watsonboyett/CanonCar/hardware/v3/Car.brd

## EAGLE design hardware/v3/Car.brd (2016-01-06)

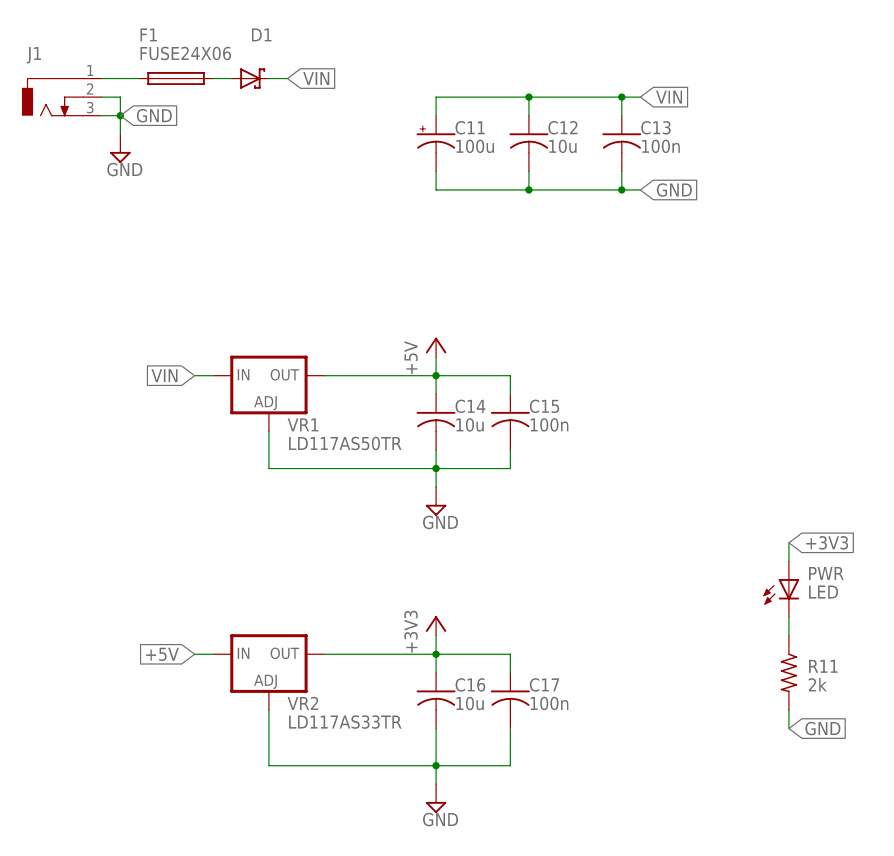
[picture p1: schematic Car.sch, sheet 1]

Parts:
C11: 100u; PANASONIC_C
C12, C14, C16: 10u; C1206
C13, C15, C17: 100n; C0805
D1: SCHOTTKY-DIODESMA; SMA
F1: FUSE24X06; 2SMD-24X06
J1: DCJ0303
PWR: LED; CHIP-LED0805
R11: 2k; R0805
VR1: LD117AS50TR; SOT223
VR2: LD117AS33TR; SOT223

Connections:
+3V3: C16.1, C17.1, PWR.A, VR2.2 (OUT), VR2.4 (OUT); also elsewhere on the board
+5V: C14.1, C15.1, VR1.2 (OUT), VR1.4 (OUT), VR2.3 (IN); also elsewhere on the board
GND: C11.-, C12.2, C13.2, C14.2, C15.2, C16.2, C17.2, J1.2, J1.3, R11.2, VR1.1 (ADJ), VR2.1 (ADJ); also elsewhere on the board
unnamed: D1.A, F1.P$2 (2)
unnamed: PWR.C, R11.1
VIN: C11.+, C12.1, C13.1, D1.C, VR1.3 (IN); also elsewhere on the board
VIN_PRF: F1.P$1 (1), J1.1

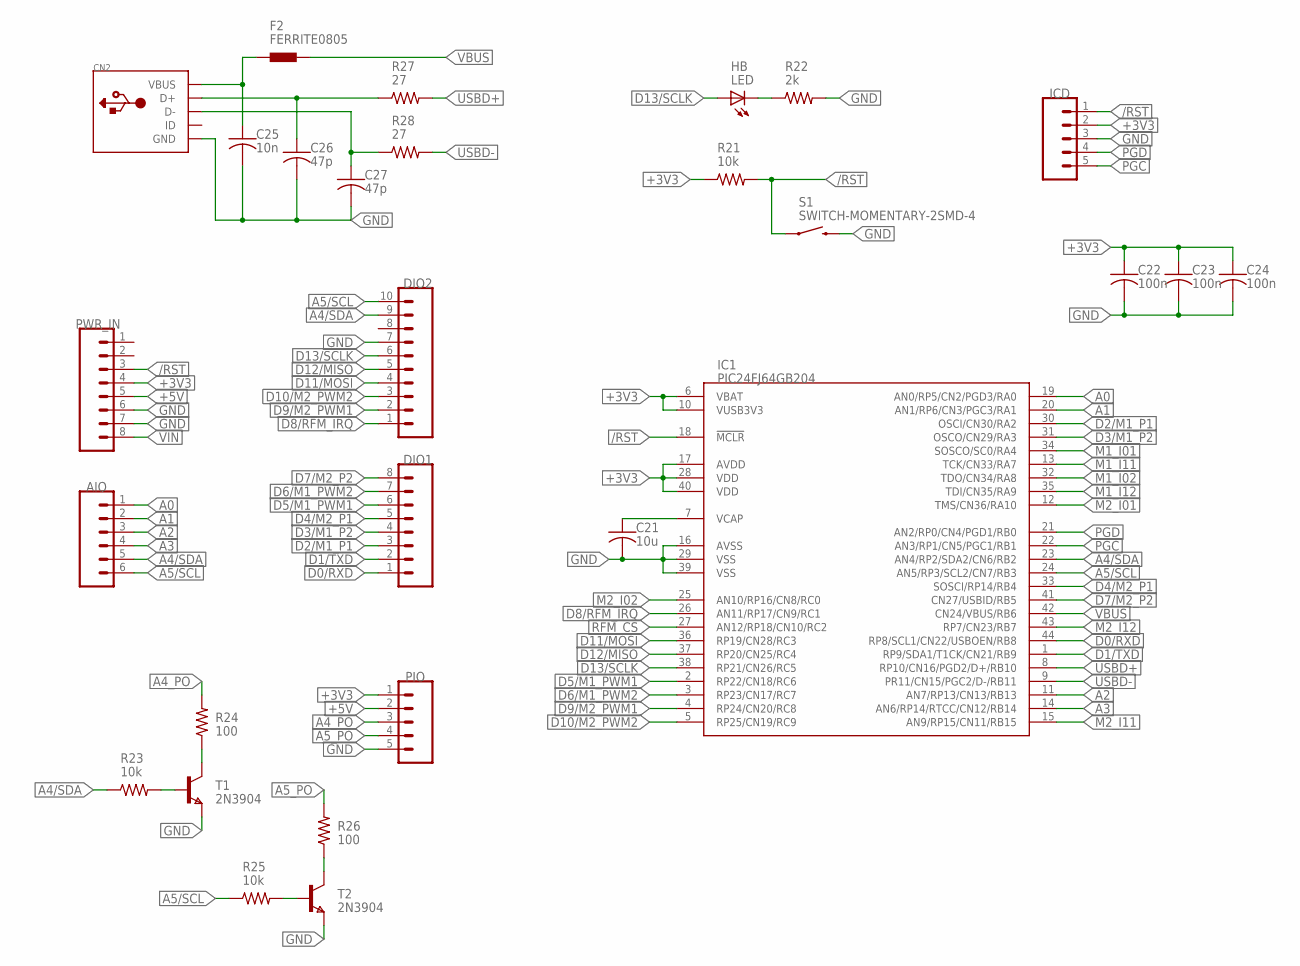
[picture p2: schematic Car.sch, sheet 2]

Parts:
AIO: M06LOCK; 1X06_LOCK
C21: 10u; C1206
C22, C23, C24: 100n; C0805
C25: 10n; C0805
C26, C27: 47p; C0805
CN2: USBMINIB; USB-MINIB
DIO1: M08LOCK; 1X08_LOCK
DIO2: M10LOCK; 1X10_LOCK
F2: FERRITE0805; 0805
HB: LED; CHIP-LED0805
IC1: PIC24FJ64GB204; TQFP44
ICD: M05LOCK; 1X05_LOCK
PIO: M05LOCK; 1X05_LOCK
PWR_IN: M08LOCK; 1X08_LOCK
R21, R23, R25: 10k; R0805
R22: 2k; R0805
R24, R26: 100; R0805
R27, R28: 27; R0805
S1: SWITCH-MOMENTARY-2SMD-4; TACTILE_SWITCH_TALL
T1, T2: 2N3904; SOT-23

Connections:
+3V3: C22.1, C23.1, C24.1, IC1.6 (VBAT), IC1.10 (VUSB3V3), IC1.17 (AVDD), IC1.28 (VDD), IC1.40 (VDD), ICD.2, PIO.1, PWR_IN.4, R21.1; also elsewhere on the board
+5V: PIO.2, PWR_IN.5; also elsewhere on the board
/RST: IC1.18 (!MCLR), ICD.1, PWR_IN.3, R21.2, S1.A2 (1); also elsewhere on the board
A0: AIO.1, IC1.19 (AN0/RP5/CN2/PGD3/RA0)
A1: AIO.2, IC1.20 (AN1/RP6/CN3/PGC3/RA1)
A2: AIO.3, IC1.11 (AN7/RP13/CN13/RB13)
A3: AIO.4, IC1.14 (AN6/RP14/RTCC/CN12/RB14)
A4/SDA: AIO.5, DIO2.9, IC1.23 (AN4/RP2/SDA2/CN6/RB2), R23.1
A4_PO: PIO.3, R24.2
A5/SCL: AIO.6, DIO2.10, IC1.24 (AN5/RP3/SCL2/CN7/RB3), R25.1
A5_PO: PIO.4, R26.2
D0/RXD: DIO1.1, IC1.44 (RP8/SCL1/CN22/USBOEN/RB8)
D1/TXD: DIO1.2, IC1.1 (RP9/SDA1/T1CK/CN21/RB9)
D2/M1_P1: DIO1.3, IC1.30 (OSCI/CN30/RA2); also elsewhere on the board
D3/M1_P2: DIO1.4, IC1.31 (OSCO/CN29/RA3); also elsewhere on the board
D4/M2_P1: DIO1.5, IC1.33 (SOSCI/RP14/RB4); also elsewhere on the board
D5/M1_PWM1: DIO1.6, IC1.2 (RP22/CN18/RC6); also elsewhere on the board
D6/M1_PWM2: DIO1.7, IC1.3 (RP23/CN17/RC7); also elsewhere on the board
D7/M2_P2: DIO1.8, IC1.41 (CN27/USBID/RB5); also elsewhere on the board
D8/RFM_IRQ: DIO2.1, IC1.26 (AN11/RP17/CN9/RC1); also elsewhere on the board
D9/M2_PWM1: DIO2.2, IC1.4 (RP24/CN20/RC8); also elsewhere on the board
D10/M2_PWM2: DIO2.3, IC1.5 (RP25/CN19/RC9); also elsewhere on the board
D11/MOSI: DIO2.4, IC1.36 (RP19/CN28/RC3); also elsewhere on the board
D12/MISO: DIO2.5, IC1.37 (RP20/CN25/RC4); also elsewhere on the board
D13/SCLK: DIO2.6, HB.A, IC1.38 (RP21/CN26/RC5); also elsewhere on the board
GND: C21.2, C22.2, C23.2, C24.2, C25.2, C26.2, C27.2, CN2.GND, DIO2.7, IC1.16 (AVSS), IC1.29 (VSS), IC1.39 (VSS), ICD.3, PIO.5, PWR_IN.6, PWR_IN.7, R22.2, S1.B2 (2), T1.2 (E), T2.2 (E); also elsewhere on the board
M1_I01: IC1.34 (SOSCO/SC0/RA4); also elsewhere on the board
M1_I02: IC1.32 (TDO/CN34/RA8); also elsewhere on the board
M1_I11: IC1.13 (TCK/CN33/RA7); also elsewhere on the board
M1_I12: IC1.35 (TDI/CN35/RA9); also elsewhere on the board
M2_I01: IC1.12 (TMS/CN36/RA10); also elsewhere on the board
M2_I02: IC1.25 (AN10/RP16/CN8/RC0); also elsewhere on the board
M2_I11: IC1.15 (AN9/RP15/CN11/RB15); also elsewhere on the board
M2_I12: IC1.43 (RP7/CN23/RB7); also elsewhere on the board
unnamed: R24.1, T1.1 (C)
unnamed: R26.1, T2.1 (C)
unnamed: R23.2, T1.3 (B)
unnamed: R25.2, T2.3 (B)
unnamed: C26.1, CN2.D+, R27.1
unnamed: C27.1, CN2.D-, R28.1
unnamed: C21.1, IC1.7 (VCAP)
unnamed: HB.C, R22.1
PGC: IC1.22 (AN3/RP1/CN5/PGC1/RB1), ICD.5
PGD: IC1.21 (AN2/RP0/CN4/PGD1/RB0), ICD.4
RFM_CS: IC1.27 (AN12/RP18/CN10/RC2); also elsewhere on the board
USBD+: IC1.8 (RP10/CN16/PGD2/D+/RB10), R27.2
USBD-: IC1.9 (PR11/CN15/PGC2/D-/RB11), R28.2
VBUS: F2.2, IC1.42 (CN24/VBUS/RB6)
VBUS-PRF: C25.1, CN2.VBUS, F2.1
VIN: PWR_IN.8; also elsewhere on the board

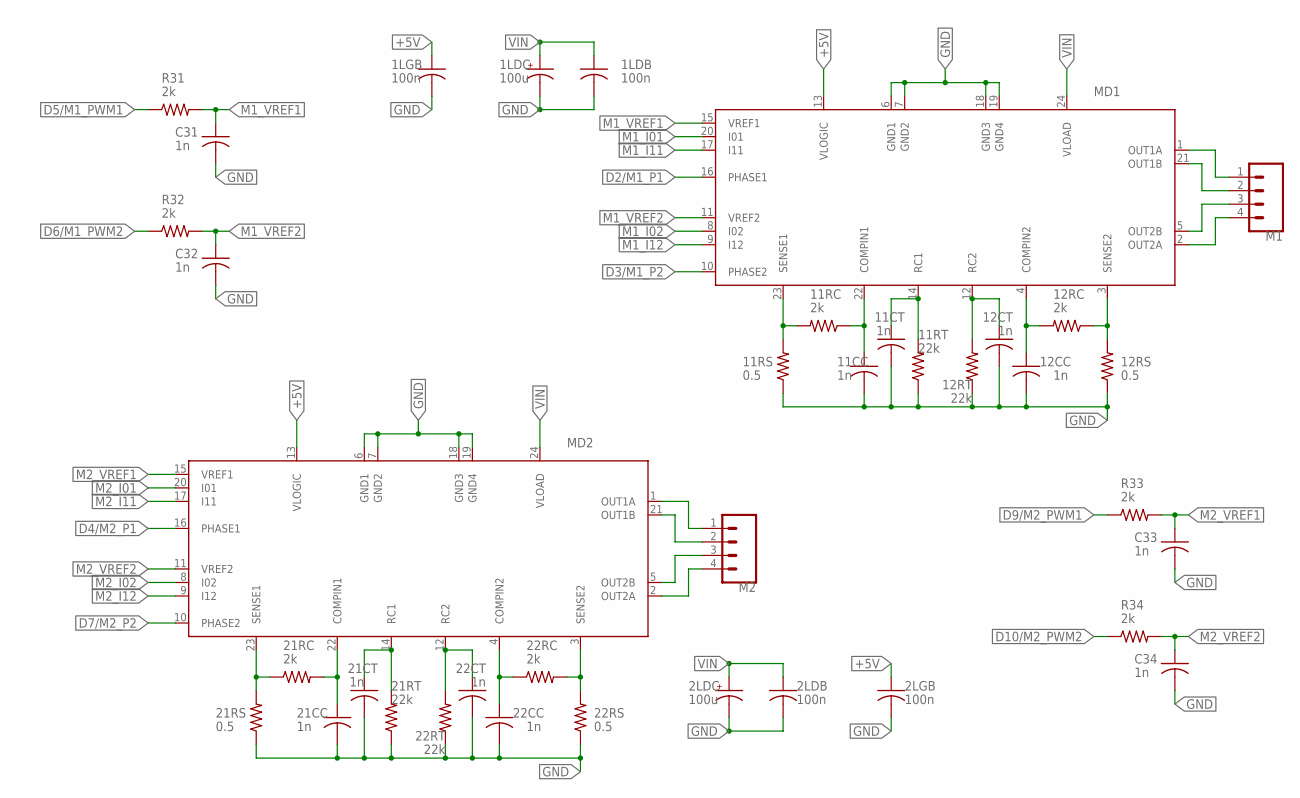
[picture p3: schematic Car.sch, sheet 3]

Parts:
1LDB, 1LGB, 2LDB, 2LGB: 100n; C0805
1LDC, 2LDC: 100u; PANASONIC_C
11CC, 11CT, 12CC, 12CT, 21CC, 21CT, 22CC, 22CT: 1n; C0805
11RC, 12RC, 21RC, 22RC: 2k; R0805
11RS, 12RS, 21RS, 22RS: 0.5; R1210
11RT, 12RT, 21RT, 22RT: 22k; R0805
C31, C32, C33, C34: 1n; C0805
M1, M2: M04LOCK; 1X04_LOCK
MD1, MD2: MTS62C19A; SOP24L
R31, R32, R33, R34: 2k; R0805

Connections:
+5V: 1LGB.1, 2LGB.1, MD1.13 (VLOGIC), MD2.13 (VLOGIC); also elsewhere on the board
D2/M1_P1: MD1.16 (PHASE1); also elsewhere on the board
D3/M1_P2: MD1.10 (PHASE2); also elsewhere on the board
D4/M2_P1: MD2.16 (PHASE1); also elsewhere on the board
D5/M1_PWM1: R31.1; also elsewhere on the board
D6/M1_PWM2: R32.1; also elsewhere on the board
D7/M2_P2: MD2.10 (PHASE2); also elsewhere on the board
D9/M2_PWM1: R33.1; also elsewhere on the board
D10/M2_PWM2: R34.1; also elsewhere on the board
GND: 1LDB.2, 1LDC.-, 1LGB.2, 2LDB.2, 2LDC.-, 2LGB.2, 11CC.2, 11CT.2, 11RS.1, 11RT.1, 12CC.2, 12CT.2, 12RS.1, 12RT.1, 21CC.2, 21CT.2, 21RS.1, 21RT.1, 22CC.2, 22CT.2, 22RS.1, 22RT.1, C31.2, C32.2, C33.2, C34.2, MD1.6 (GND1), MD1.7 (GND2), MD1.18 (GND3), MD1.19 (GND4), MD2.6 (GND1), MD2.7 (GND2), MD2.18 (GND3), MD2.19 (GND4); also elsewhere on the board
M1_I01: MD1.20 (I01); also elsewhere on the board
M1_I02: MD1.8 (I02); also elsewhere on the board
M1_I11: MD1.17 (I11); also elsewhere on the board
M1_I12: MD1.9 (I12); also elsewhere on the board
M1_VREF1: C31.1, MD1.15 (VREF1), R31.2
M1_VREF2: C32.1, MD1.11 (VREF2), R32.2
M2_I01: MD2.20 (I01); also elsewhere on the board
M2_I02: MD2.8 (I02); also elsewhere on the board
M2_I11: MD2.17 (I11); also elsewhere on the board
M2_I12: MD2.9 (I12); also elsewhere on the board
M2_VREF1: C33.1, MD2.15 (VREF1), R33.2
M2_VREF2: C34.1, MD2.11 (VREF2), R34.2
unnamed: M1.2, MD1.21 (OUT1B)
unnamed: M1.1, MD1.1 (OUT1A)
unnamed: M1.3, MD1.5 (OUT2B)
unnamed: M1.4, MD1.2 (OUT2A)
unnamed: M2.2, MD2.21 (OUT1B)
unnamed: M2.1, MD2.1 (OUT1A)
unnamed: M2.3, MD2.5 (OUT2B)
unnamed: M2.4, MD2.2 (OUT2A)
unnamed: 21RC.1, 21RS.2, MD2.23 (SENSE1)
unnamed: 21CC.1, 21RC.2, MD2.22 (COMPIN1)
unnamed: 22CT.1, 22RT.2, MD2.12 (RC2)
unnamed: 22RC.2, 22RS.2, MD2.3 (SENSE2)
unnamed: 22CC.1, 22RC.1, MD2.4 (COMPIN2)
unnamed: 21CT.1, 21RT.2, MD2.14 (RC1)
unnamed: 11RC.2, 11RS.2, MD1.23 (SENSE1)
unnamed: 11CC.1, 11RC.1, MD1.22 (COMPIN1)
unnamed: 12CC.1, 12RC.2, MD1.4 (COMPIN2)
unnamed: 12RC.1, 12RS.2, MD1.3 (SENSE2)
unnamed: 11CT.1, 11RT.2, MD1.14 (RC1)
unnamed: 12CT.1, 12RT.2, MD1.12 (RC2)
VIN: 1LDB.1, 1LDC.+, 2LDB.1, 2LDC.+, MD1.24 (VLOAD), MD2.24 (VLOAD); also elsewhere on the board

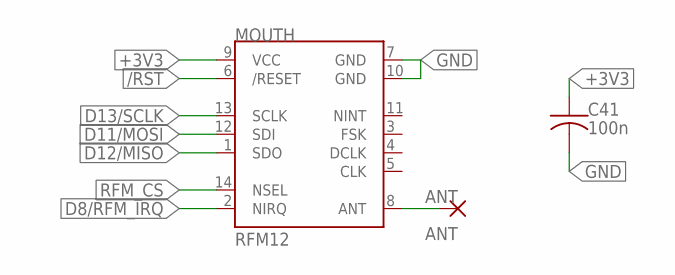
[picture p4: schematic Car.sch, sheet 4]

Parts:
ANT: ANT; 2,15/1,0
C41: 100n; C0805
MOUTH: RFM12; RFM12-XXX-S2

Connections:
+3V3: C41.1, MOUTH.9 (VCC); also elsewhere on the board
GND: C41.2, MOUTH.7 (GND), MOUTH.10 (GND); also elsewhere on the board
unnamed 48: ANT.1, MOUTH.8 (ANT); also elsewhere on the board

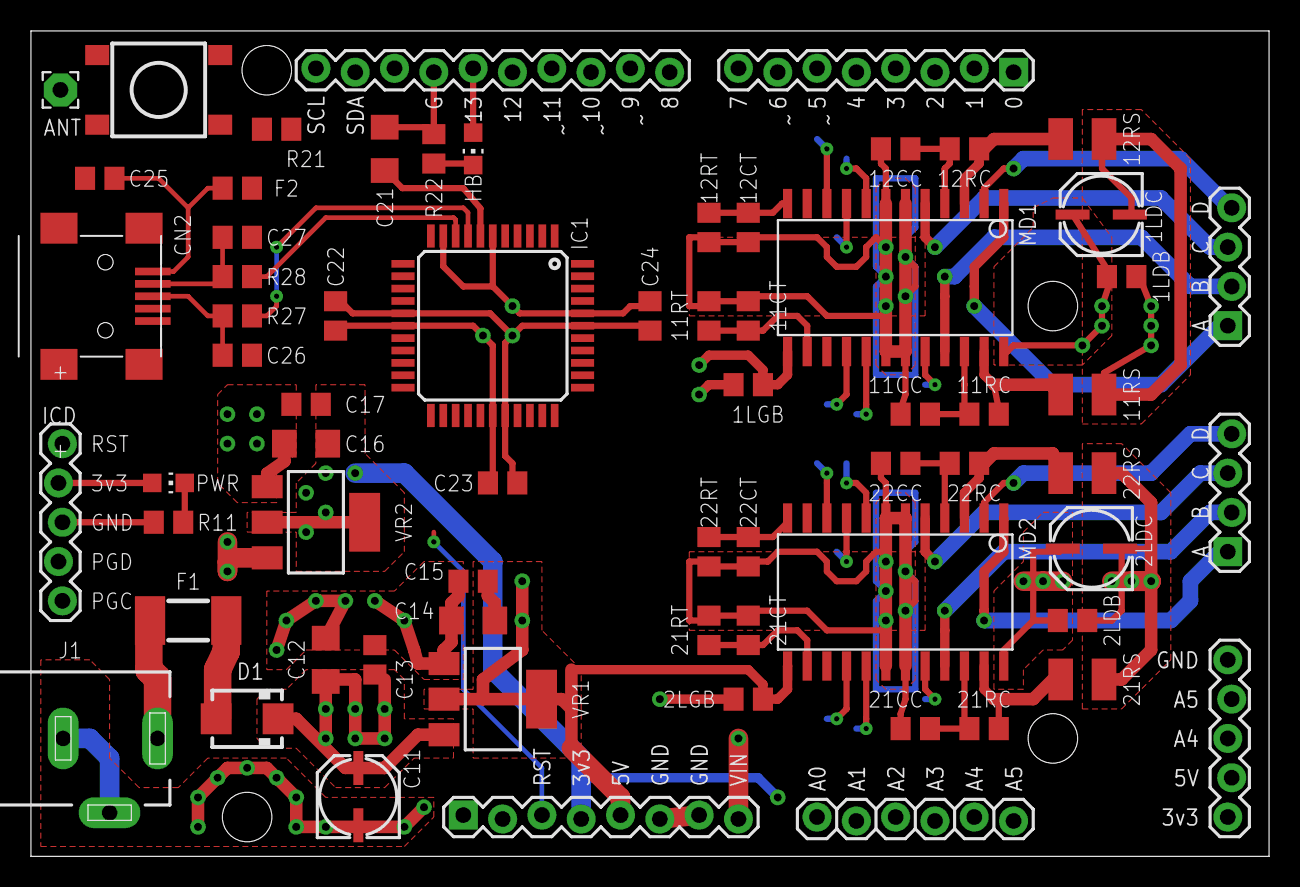
[picture p5: board hardware/v3/Car.brd from above]

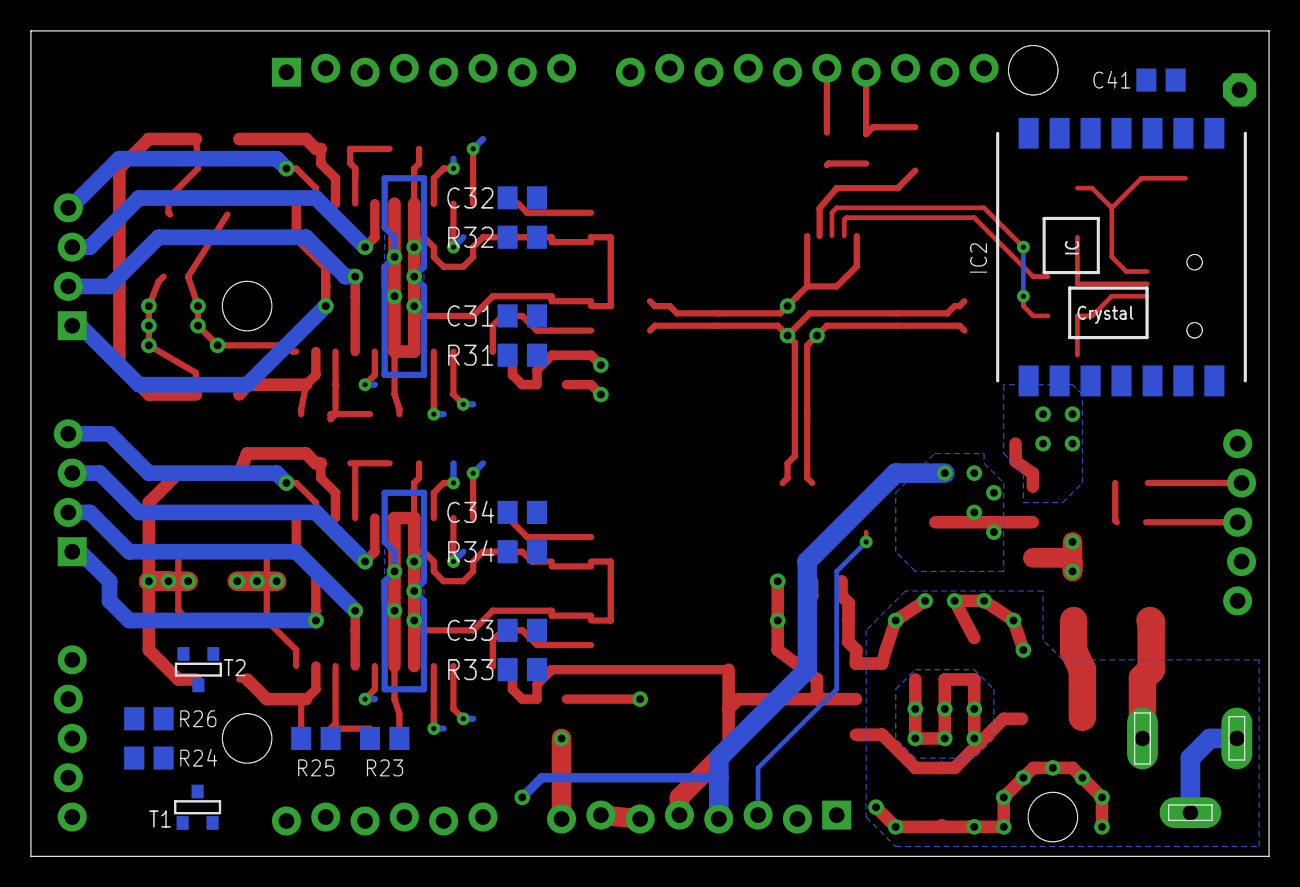
[picture p6: board hardware/v3/Car.brd from below]

Board: 4 copper layers, 80.0 x 53.3 mm, 83 parts (16 on the bottom side), 78 nets.

Other parts of the board:
IC2: RFM12; RFM12-XXX-S2

Their connections:
+3V3: IC2.9; also elsewhere on the board
/RST: IC2.6; also elsewhere on the board
D8/RFM_IRQ: IC2.2; also elsewhere on the board
D11/MOSI: IC2.12; also elsewhere on the board
D12/MISO: IC2.1; also elsewhere on the board
D13/SCLK: IC2.13; also elsewhere on the board
GND: IC2.7, IC2.10; also elsewhere on the board
unnamed 48: IC2.8; also elsewhere on the board
RFM_CS: IC2.14; also elsewhere on the board
