watsonboyett/CanonCar/hardware/v2/Car.brd

## EAGLE design hardware/v2/Car.brd (2015-11-19, an earlier design)

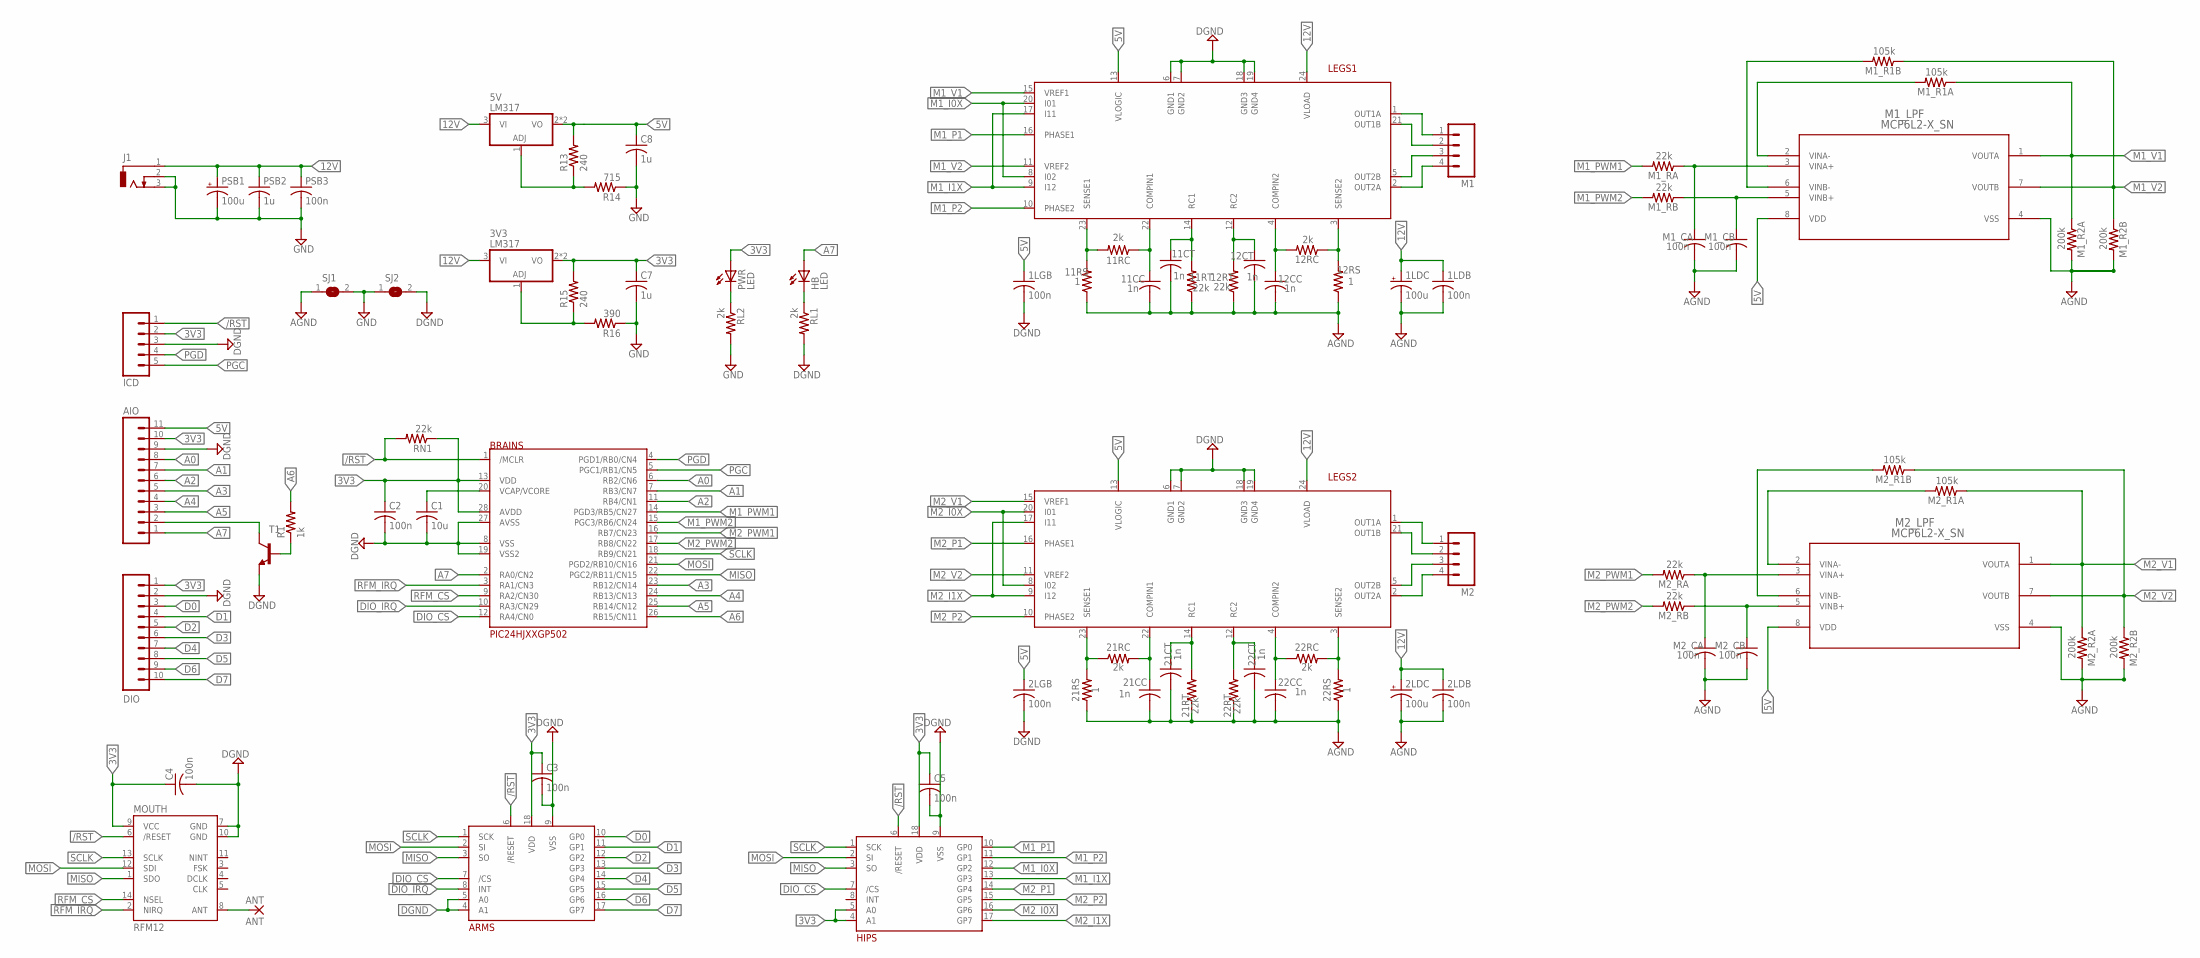
[picture p7: schematic Car.sch]

Parts:
1LDB, 1LGB, 2LDB, 2LGB: 100n; C0805
1LDC, 2LDC: 100u; PANASONIC_C
3V3, 5V: LM317; SOT23
11CC, 11CT, 12CC, 12CT, 21CC, 21CT, 22CC, 22CT: 1n; C0805
11RC, 12RC, 21RC, 22RC: 2k; R0805
11RS, 12RS, 21RS, 22RS: 1; R2512
11RT, 12RT, 21RT, 22RT: 22k; R0805
AIO: M11LOCK; 1X11_LOCK
ANT: ANT; 2,15/1,0
ARMS: MCP23S08; SO-18W
BRAINS: PIC24HJXXGP502; SO28W
C1: 10u; C1206
C2, C3, C4, C5: 100n; C0805
C7, C8: 1u; C1206
DIO: M10LOCK; 1X10_LOCK
HB: LED; CHIP-LED0805
HIPS: MCP23S08; SO-18W
ICD: M05LOCK; 1X05_LOCK
J1: DCJ0303
LEGS1, LEGS2: MTS62C19A; SOP24L
M1, M2: M04LOCK_LONGPADS; 1X04_LOCK_LONGPADS
M1_CA, M1_CB, M2_CA, M2_CB: 100n; C0805
M1_LPF, M2_LPF: MCP6L2-X_SN; SOIC8-N_MC
M1_R1A, M1_R1B, M2_R1A, M2_R1B: 105k; R0805
M1_R2A, M1_R2B, M2_R2A, M2_R2B: 200k; R0805
M1_RA, M1_RB, M2_RA, M2_RB: 22k; R0805
MOUTH: RFM12; RFM12-XXX-S2
PSB1: 100u; PANASONIC_C
PSB2: 1u; C1206
PSB3: 100n; C0805
PWR: LED; CHIP-LED0805
R1: 1k; R0805
R13, R15: 240; R0805
R14: 715; R0805
R16: 390; R0805
RL1, RL2: 2k; R0805
RN1: 22k; R0805
SJ1, SJ2: SJ
T1: BC817-16-NPN-SOT23-BEC; SOT23-BEC

Connections:
3V3: 3V3.2 (VO), 3V3.4 (VO), AIO.10, ARMS.18 (VDD), BRAINS.13 (VDD), BRAINS.28 (AVDD), C2.1, C3.1, C4.1, C5.1, C7.1, DIO.1, HIPS.4 (A1), HIPS.5 (A0), HIPS.18 (VDD), ICD.2, MOUTH.9 (VCC), PWR.A, R15.2, RN1.1
5V: 1LGB.1, 2LGB.1, 5V.2 (VO), 5V.4 (VO), AIO.11, C8.1, LEGS1.13 (VLOGIC), LEGS2.13 (VLOGIC), M1_LPF.8 (VDD), M2_LPF.8 (VDD), R13.2
12V: 1LDB.1, 1LDC.+, 2LDB.1, 2LDC.+, 3V3.3 (VI), 5V.3 (VI), J1.1, LEGS1.24 (VLOAD), LEGS2.24 (VLOAD), PSB1.+, PSB2.1, PSB3.1
/RST: ARMS.6 (/RESET), BRAINS.1 (/MCLR), HIPS.6 (/RESET), ICD.1, MOUTH.6 (/RESET), RN1.2
A0: AIO.8, BRAINS.6 (RB2/CN6)
A1: AIO.7, BRAINS.7 (RB3/CN7)
A2: AIO.6, BRAINS.11 (RB4/CN1)
A3: AIO.5, BRAINS.23 (RB12/CN14)
A4: AIO.4, BRAINS.24 (RB13/CN13)
A5: AIO.3, BRAINS.25 (RB14/CN12)
A6: BRAINS.26 (RB15/CN11), R1.2
A7: AIO.1, BRAINS.2 (RA0/CN2), HB.A
AGND: 1LDB.2, 1LDC.-, 2LDB.2, 2LDC.-, 11CC.2, 11CT.2, 11RS.1, 11RT.1, 12CC.2, 12CT.2, 12RS.1, 12RT.1, 21CC.2, 21CT.2, 21RS.1, 21RT.1, 22CC.2, 22CT.2, 22RS.1, 22RT.1, M1_CA.2, M1_CB.2, M1_LPF.4 (VSS), M1_R2A.2, M1_R2B.2, M2_CA.2, M2_CB.2, M2_LPF.4 (VSS), M2_R2A.2, M2_R2B.2, SJ1.1
D0: ARMS.10 (GP0), DIO.3
D1: ARMS.11 (GP1), DIO.4
D2: ARMS.12 (GP2), DIO.5
D3: ARMS.13 (GP3), DIO.6
D4: ARMS.14 (GP4), DIO.7
D5: ARMS.15 (GP5), DIO.8
D6: ARMS.16 (GP6), DIO.9
D7: ARMS.17 (GP7), DIO.10
DGND: 1LGB.2, 2LGB.2, AIO.9, ARMS.4 (A1), ARMS.5 (A0), ARMS.9 (VSS), BRAINS.8 (VSS), BRAINS.19 (VSS2), BRAINS.27 (AVSS), C1.2, C2.2, C3.2, C4.2, C5.2, DIO.2, HIPS.9 (VSS), ICD.3, LEGS1.6 (GND1), LEGS1.7 (GND2), LEGS1.18 (GND3), LEGS1.19 (GND4), LEGS2.6 (GND1), LEGS2.7 (GND2), LEGS2.18 (GND3), LEGS2.19 (GND4), MOUTH.7 (GND), MOUTH.10 (GND), RL1.2, SJ2.2, T1.E
DIO_CS: ARMS.7 (/CS), BRAINS.12 (RA4/CN0), HIPS.7 (/CS)
DIO_IRQ: ARMS.8 (INT), BRAINS.10 (RA3/CN29)
GND: C7.2, C8.2, J1.2, J1.3, PSB1.-, PSB2.2, PSB3.2, R14.1, R16.1, RL2.2, SJ1.2, SJ2.1
M1_I0X: HIPS.12 (GP2), LEGS1.8 (I02), LEGS1.20 (I01)
M1_I1X: HIPS.13 (GP3), LEGS1.9 (I12), LEGS1.17 (I11)
M1_P1: HIPS.10 (GP0), LEGS1.16 (PHASE1)
M1_P2: HIPS.11 (GP1), LEGS1.10 (PHASE2)
M1_PWM1: BRAINS.14 (PGD3/RB5/CN27), M1_RA.2
M1_PWM2: BRAINS.15 (PGC3/RB6/CN24), M1_RB.2
M1_V1: LEGS1.15 (VREF1), M1_LPF.1 (VOUTA), M1_R1A.1, M1_R2A.1
M1_V2: LEGS1.11 (VREF2), M1_LPF.7 (VOUTB), M1_R1B.1, M1_R2B.1
M2_I0X: HIPS.16 (GP6), LEGS2.8 (I02), LEGS2.20 (I01)
M2_I1X: HIPS.17 (GP7), LEGS2.9 (I12), LEGS2.17 (I11)
M2_P1: HIPS.14 (GP4), LEGS2.16 (PHASE1)
M2_P2: HIPS.15 (GP5), LEGS2.10 (PHASE2)
M2_PWM1: BRAINS.16 (RB7/CN23), M2_RA.2
M2_PWM2: BRAINS.17 (RB8/CN22), M2_RB.2
M2_V1: LEGS2.15 (VREF1), M2_LPF.1 (VOUTA), M2_R1A.1, M2_R2A.1
M2_V2: LEGS2.11 (VREF2), M2_LPF.7 (VOUTB), M2_R1B.1, M2_R2B.1
MISO: ARMS.3 (SO), BRAINS.22 (PGC2/RB11/CN15), HIPS.3 (SO), MOUTH.1 (SDO)
MOSI: ARMS.2 (SI), BRAINS.21 (PGD2/RB10/CN16), HIPS.2 (SI), MOUTH.12 (SDI)
unnamed: LEGS1.21 (OUT1B), M1.2
unnamed: LEGS1.1 (OUT1A), M1.1
unnamed: M1_CA.1, M1_LPF.3 (VINA+), M1_RA.1
unnamed: LEGS1.5 (OUT2B), M1.3
unnamed: LEGS1.2 (OUT2A), M1.4
unnamed: LEGS2.21 (OUT1B), M2.2
unnamed: M1_LPF.2 (VINA-), M1_R1A.2
unnamed: LEGS2.1 (OUT1A), M2.1
unnamed: LEGS2.5 (OUT2B), M2.3
unnamed: LEGS2.2 (OUT2A), M2.4
unnamed: ANT.1, MOUTH.8 (ANT)
unnamed: M2_CA.1, M2_LPF.3 (VINA+), M2_RA.1
unnamed: 21RC.1, 21RS.2, LEGS2.23 (SENSE1)
unnamed: 21CC.1, 21RC.2, LEGS2.22 (COMPIN1)
unnamed: 22CT.1, 22RT.2, LEGS2.12 (RC2)
unnamed: 22RC.2, 22RS.2, LEGS2.3 (SENSE2)
unnamed: 22CC.1, 22RC.1, LEGS2.4 (COMPIN2)
unnamed: 21CT.1, 21RT.2, LEGS2.14 (RC1)
unnamed: M2_LPF.2 (VINA-), M2_R1A.2
unnamed: 3V3.1 (ADJ), R15.1, R16.2
unnamed: M1_LPF.6 (VINB-), M1_R1B.2
unnamed: M1_CB.1, M1_LPF.5 (VINB+), M1_RB.1
unnamed: M2_LPF.6 (VINB-), M2_R1B.2
unnamed: M2_CB.1, M2_LPF.5 (VINB+), M2_RB.1
unnamed: AIO.2, T1.C
unnamed: 5V.1 (ADJ), R13.1, R14.2
unnamed: R1.1, T1.B
unnamed: 11RC.2, 11RS.2, LEGS1.23 (SENSE1)
unnamed: 11CC.1, 11RC.1, LEGS1.22 (COMPIN1)
unnamed: 12CC.1, 12RC.2, LEGS1.4 (COMPIN2)
unnamed: 12RC.1, 12RS.2, LEGS1.3 (SENSE2)
unnamed: BRAINS.20 (VCAP/VCORE), C1.1
unnamed: 11CT.1, 11RT.2, LEGS1.14 (RC1)
unnamed: 12CT.1, 12RT.2, LEGS1.12 (RC2)
unnamed: HB.C, RL1.1
unnamed: PWR.C, RL2.1
PGC: BRAINS.5 (PGC1/RB1/CN5), ICD.5
PGD: BRAINS.4 (PGD1/RB0/CN4), ICD.4
RFM_CS: BRAINS.9 (RA2/CN30), MOUTH.14 (NSEL)
RFM_IRQ: BRAINS.3 (RA1/CN3), MOUTH.2 (NIRQ)
SCLK: ARMS.1 (SCK), BRAINS.18 (RB9/CN21), HIPS.1 (SCK), MOUTH.13 (SCLK)

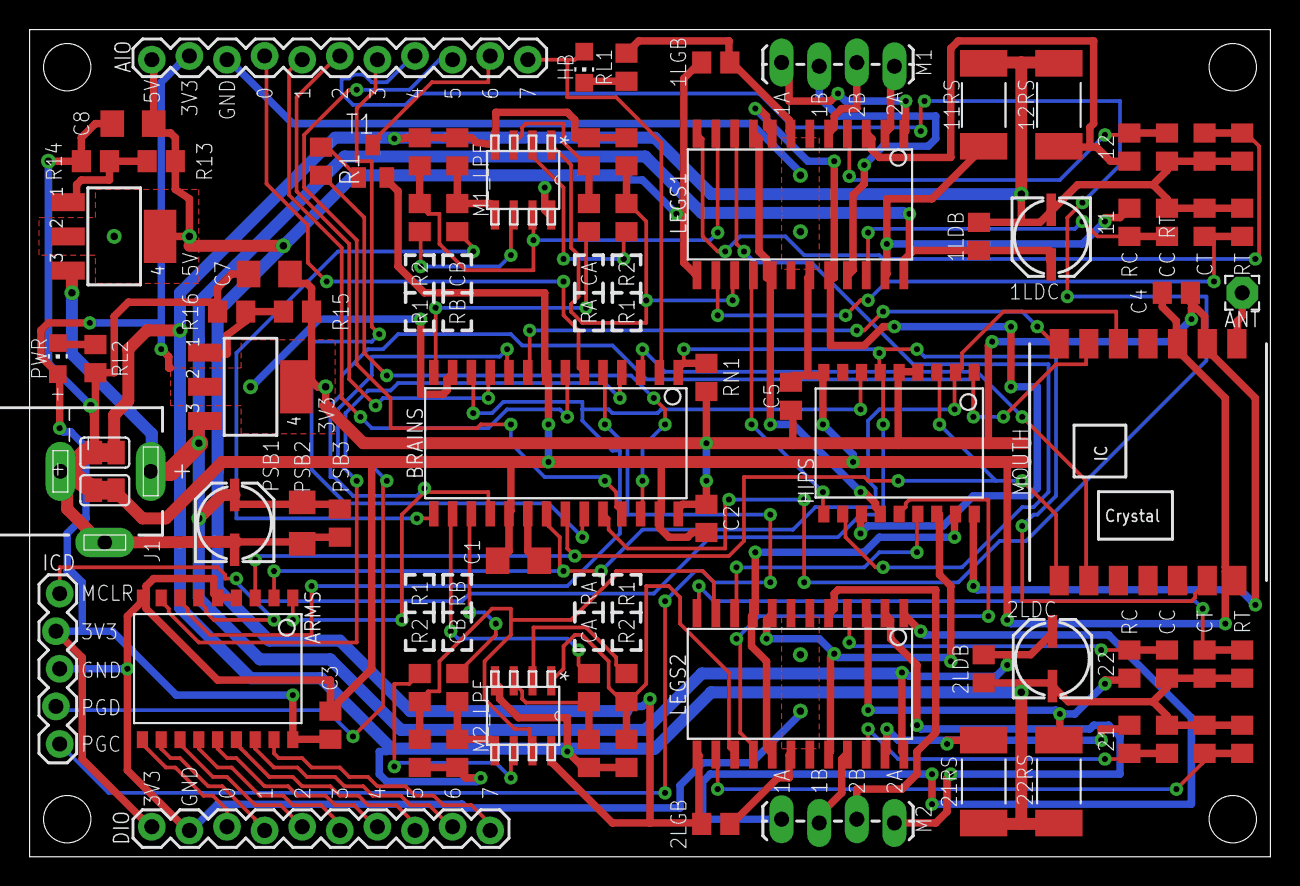
[picture p8: board hardware/v2/Car.brd from above]

Board: 2 copper layers, 83.8 x 55.9 mm, 82 parts (0 on the bottom side), 84 nets.
