watsonboyett/CanonCar/hardware/v1/Car.brd

## EAGLE design hardware/v1/Car.brd (2014-11-26, an earlier design)

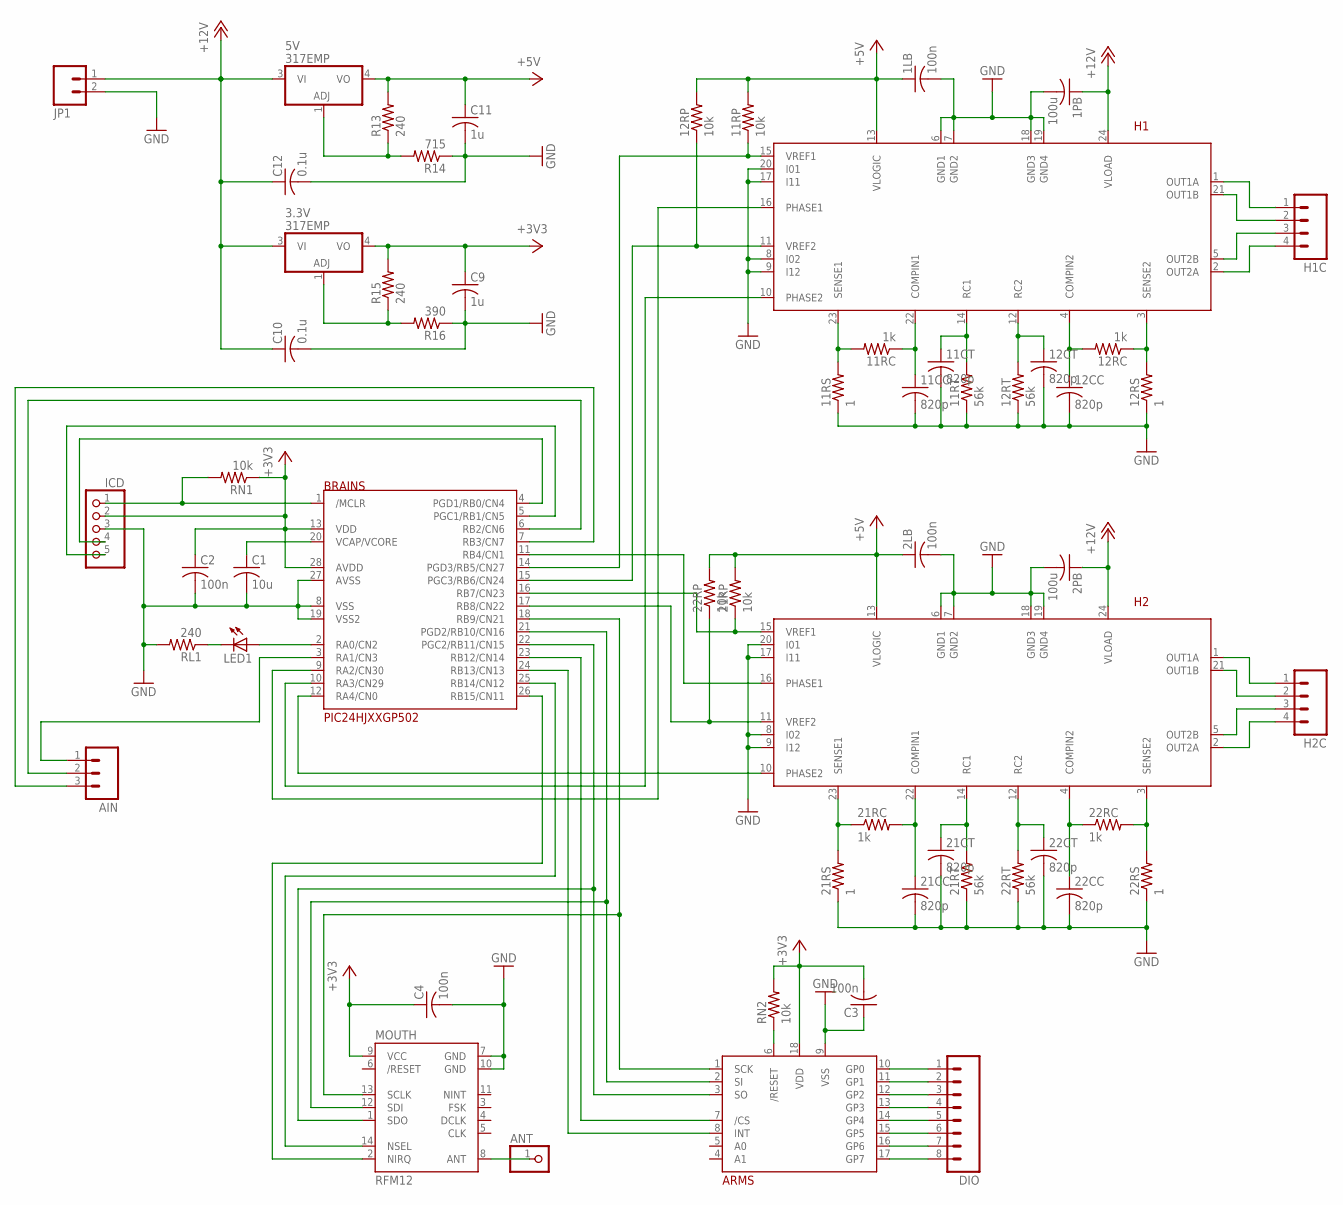
[picture p9: schematic Car.sch]

Parts:
1LB, 2LB: 100n; C0805
1PB, 2PB: 100u; C0805
3.3V, 5V: 317EMP; SOT223
11CC, 11CT, 12CC, 12CT, 21CC, 21CT, 22CC, 22CT: 820p; C0805
11RC, 12RC, 21RC, 22RC: 1k; R0805
11RP, 12RP, 21RP, 22RP: 10k; R0805
11RS, 12RS, 21RS, 22RS: 1; R2512
11RT, 12RT, 21RT, 22RT: 56k; R0805
AIN: M03POLAR; MOLEX-1X3
ANT: PINHD-1X1; 1X01
ARMS: MCP23S08; SO-18W
BRAINS: PIC24HJXXGP502; SO28W
C1: 10u; C0805
C2, C3, C4: 100n; C0805
C9, C11: 1u; C0805
C10, C12: 0.1u; C0805
DIO: M081X08; 1X08
H1, H2: MTS62C19A; SOP24L
H1C, H2C: M04POLAR; MOLEX-1X4
ICD: PINHD-1X5; 1X05
JP1: M02POLAR; MOLEX-1X2
LED1: LEDCHIP-LED0805; CHIP-LED0805
MOUTH: RFM12; RFM12-XXX-S2
R13, R15: 240; R0805
R14: 715; R0805
R16: 390; R0805
RL1: 240; R0805
RN1, RN2: 10k; R0805

Connections:
+3V3: 3.3V.4 (VO), ARMS.18 (VDD), BRAINS.13 (VDD), BRAINS.28 (AVDD), C2.1, C3.2, C4.1, C9.1, ICD.2, MOUTH.9 (VCC), R15.2, RN1.1, RN2.2
+5V: 1LB.1, 2LB.1, 5V.4 (VO), 11RP.2, 12RP.2, 21RP.2, 22RP.2, C11.1, H1.13 (VLOGIC), H2.13 (VLOGIC), R13.2
+12V: 1PB.1, 2PB.1, 3.3V.3 (VI), 5V.3 (VI), C10.1, C12.1, H1.24 (VLOAD), H2.24 (VLOAD), JP1.1
GND: 1LB.2, 1PB.2, 2LB.2, 2PB.2, 11CC.2, 11CT.2, 11RS.1, 11RT.1, 12CC.2, 12CT.2, 12RS.1, 12RT.1, 21CC.2, 21CT.2, 21RS.1, 21RT.1, 22CC.2, 22CT.2, 22RS.1, 22RT.1, ARMS.9 (VSS), BRAINS.8 (VSS), BRAINS.19 (VSS2), BRAINS.27 (AVSS), C1.2, C2.2, C3.1, C4.2, C9.2, C10.2, C11.2, C12.2, H1.6 (GND1), H1.7 (GND2), H1.8 (I02), H1.9 (I12), H1.17 (I11), H1.18 (GND3), H1.19 (GND4), H1.20 (I01), H2.6 (GND1), H2.7 (GND2), H2.8 (I02), H2.9 (I12), H2.17 (I11), H2.18 (GND3), H2.19 (GND4), H2.20 (I01), ICD.3, JP1.2, MOUTH.7 (GND), MOUTH.10 (GND), R14.1, R16.1, RL1.2
unnamed: H1.21 (OUT1B), H1C.2
unnamed: H1.1 (OUT1A), H1C.1
unnamed: BRAINS.4 (PGD1/RB0/CN4), ICD.4
unnamed: H1.5 (OUT2B), H1C.3
unnamed: H1.2 (OUT2A), H1C.4
unnamed: H2.21 (OUT1B), H2C.2
unnamed: ARMS.1 (SCK), BRAINS.18 (RB9/CN21), MOUTH.13 (SCLK)
unnamed: H2.1 (OUT1A), H2C.1
unnamed: H2.5 (OUT2B), H2C.3
unnamed: H2.2 (OUT2A), H2C.4
unnamed: BRAINS.1 (/MCLR), ICD.1, RN1.2
unnamed: ARMS.16 (GP6), DIO.7
unnamed: 21RC.1, 21RS.2, H2.23 (SENSE1)
unnamed: 21CC.1, 21RC.2, H2.22 (COMPIN1)
unnamed: 22CT.1, 22RT.2, H2.12 (RC2)
unnamed: 22RC.2, 22RS.2, H2.3 (SENSE2)
unnamed: 22CC.1, 22RC.1, H2.4 (COMPIN2)
unnamed: 21CT.1, 21RT.2, H2.14 (RC1)
unnamed: 22RP.1, BRAINS.17 (RB8/CN22), H2.11 (VREF2)
unnamed: 3.3V.1 (ADJ), R15.1, R16.2
unnamed: 12RP.1, BRAINS.15 (PGC3/RB6/CN24), H1.11 (VREF2)
unnamed: BRAINS.25 (RB14/CN12), MOUTH.14 (NSEL)
unnamed: BRAINS.11 (RB4/CN1), H2.16 (PHASE1)
unnamed: BRAINS.26 (RB15/CN11), MOUTH.2 (NIRQ)
unnamed: ARMS.2 (SI), BRAINS.21 (PGD2/RB10/CN16), MOUTH.12 (SDI)
unnamed: ARMS.3 (SO), BRAINS.22 (PGC2/RB11/CN15), MOUTH.1 (SDO)
unnamed: 5V.1 (ADJ), R13.1, R14.2
unnamed: BRAINS.5 (PGC1/RB1/CN5), ICD.5
unnamed: BRAINS.9 (RA2/CN30), H1.16 (PHASE1)
unnamed: 11RP.1, BRAINS.14 (PGD3/RB5/CN27), H1.15 (VREF1)
unnamed: 11RC.2, 11RS.2, H1.23 (SENSE1)
unnamed: BRAINS.10 (RA3/CN29), H1.10 (PHASE2)
unnamed: 11CC.1, 11RC.1, H1.22 (COMPIN1)
unnamed: 12CC.1, 12RC.2, H1.4 (COMPIN2)
unnamed: 12RC.1, 12RS.2, H1.3 (SENSE2)
unnamed: ARMS.7 (/CS), BRAINS.23 (RB12/CN14)
unnamed: ARMS.8 (INT), BRAINS.24 (RB13/CN13)
unnamed: 21RP.1, BRAINS.16 (RB7/CN23), H2.15 (VREF1)
unnamed: ANT.1, MOUTH.8 (ANT)
unnamed: BRAINS.20 (VCAP/VCORE), C1.1
unnamed: 11CT.1, 11RT.2, H1.14 (RC1)
unnamed: 12CT.1, 12RT.2, H1.12 (RC2)
unnamed: ARMS.10 (GP0), DIO.1
unnamed: ARMS.11 (GP1), DIO.2
unnamed: BRAINS.2 (RA0/CN2), LED1.A
unnamed: LED1.C, RL1.1
unnamed: BRAINS.12 (RA4/CN0), H2.10 (PHASE2)
unnamed: ARMS.12 (GP2), DIO.3
unnamed: ARMS.13 (GP3), DIO.4
unnamed: ARMS.14 (GP4), DIO.5
unnamed: ARMS.15 (GP5), DIO.6
unnamed: ARMS.17 (GP7), DIO.8
unnamed: AIN.1, BRAINS.3 (RA1/CN3)
unnamed: AIN.2, BRAINS.6 (RB2/CN6)
unnamed: AIN.3, BRAINS.7 (RB3/CN7)
unnamed: ARMS.6 (/RESET), RN2.1
