watsonboyett/CanonCar/hardware/v1/Car.brd

## EAGLE design hardware/v1/Car.brd (continued)

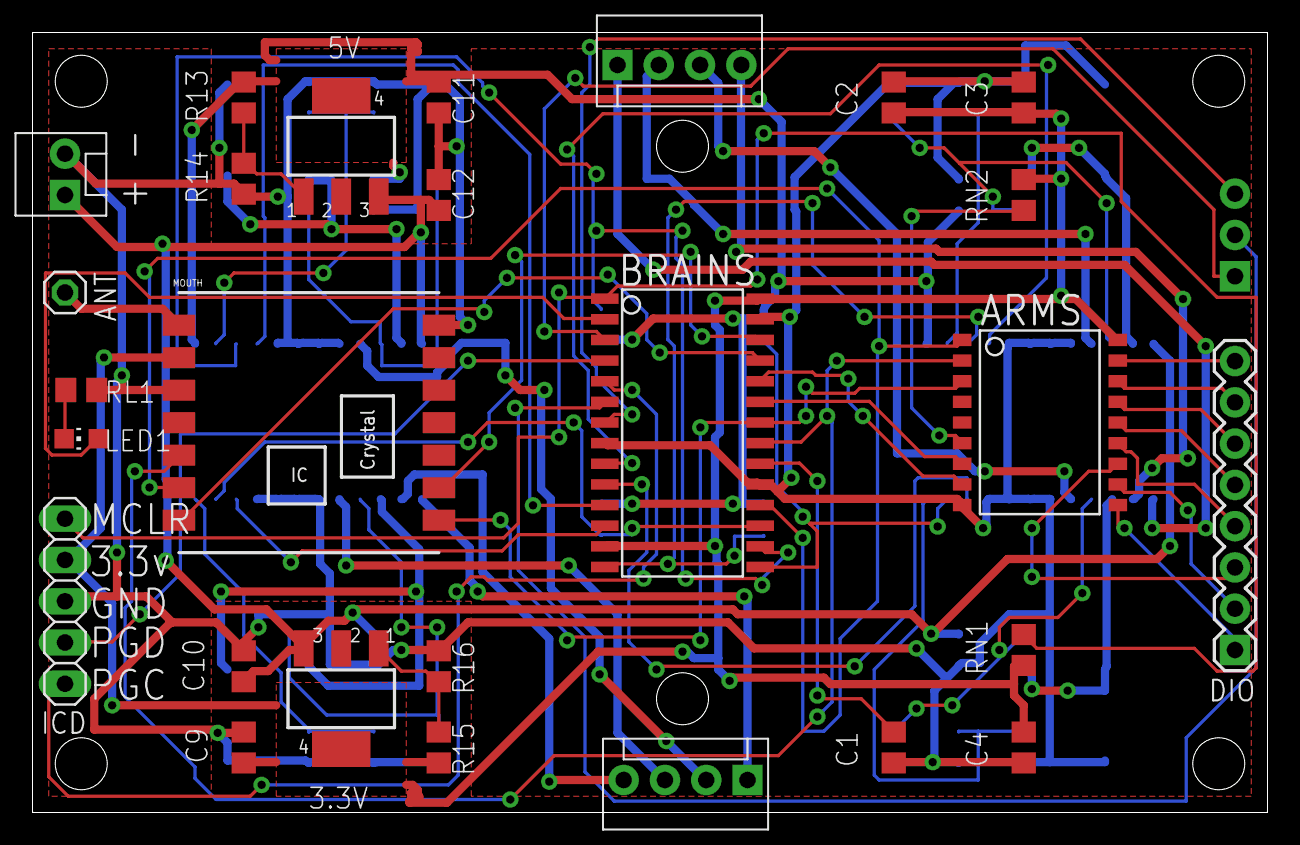
[picture p10: board hardware/v1/Car.brd from above]

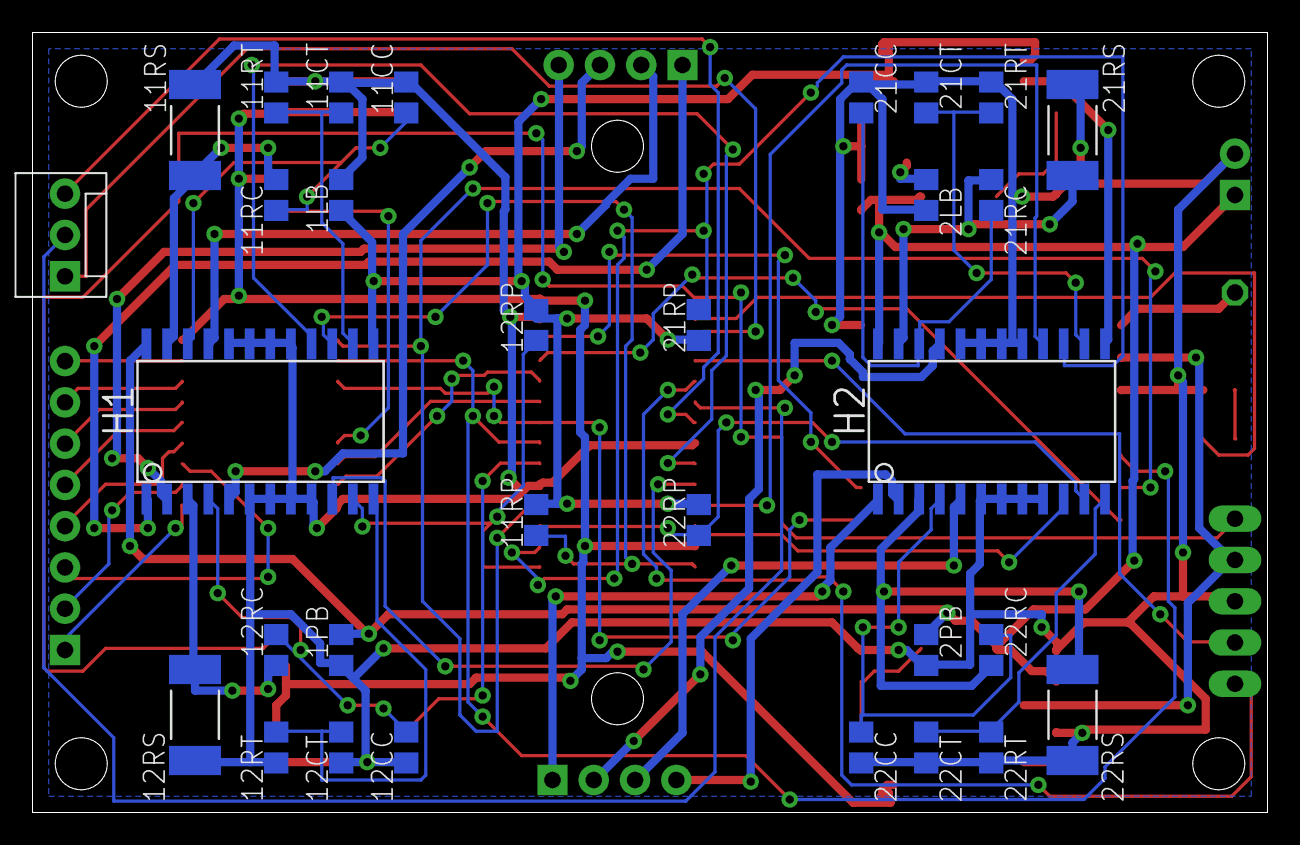
[picture p11: board hardware/v1/Car.brd from below]

Board: 2 copper layers, 76.0 x 48.0 mm, 58 parts (31 on the bottom side), 60 nets.
