watsonboyett/CanonCar/firmware/StickControl.X/source/bsp/configuration_bits.c

#include "device.h"

/******************************************************************************/
/* Configuration Bits                                                         */
/*                                                                            */
/* This is not all available configuration bits for all PIC24 devices.        */
/* Refer to the PIC24 device specific .h file in the compiler                 */
/* support\PIC24x\h (x=F,H,E) directory for complete options specific to the  */
/* selected device.  For additional information about what the hardware       */
/* configurations mean in terms of device operation, refer to the device      */
/* datasheet 'Special Features' chapter.                                      */
/*                                                                            */
/* A feature of MPLAB X is the 'Generate Source Code to Output' utility in    */
/* the Configuration Bits window.  Under Window > PIC Memory Views >          */
/* Configuration Bits, a user controllable configuration bits window is       */
/* available to Generate Configuration Bits source code which the user can    */
/* paste into this project.                                                   */
/******************************************************************************/

/* TODO Fill in your configuration bits from the config bits generator here.  */


// TODO: use "#pragma config ..." for config bits
// Select Internal FRC at POR
_FOSCSEL(FNOSC_FRCPLL);
// Enable Clock Switching and Configure
_FOSC(FCKSM_CSECMD & OSCIOFNC_ON & IOL1WAY_OFF);
// Disable watchdog timer
_FWDT(FWDTEN_OFF);
