watsonboyett/CanonCar/firmware/StickControl.X/source/bsp/device.h

#ifndef DEVICE_H
#define	DEVICE_H

/* Device header file */
#if defined(__XC16__)
    #include <xc.h>
#elif defined(__C30__)
    #if defined(__PIC24E__)
    	#include <p24Exxxx.h>
    #elif defined (__PIC24F__)||defined (__PIC24FK__)
	#include <p24Fxxxx.h>
    #elif defined(__PIC24H__)
	#include <p24Hxxxx.h>
    #endif
#endif      


#endif
