watsonboyett/CanonCar/firmware/StickControl.X/source/hal/util.h

#ifndef UTIL_H
#define UTIL_H

#include <stdint.h>

#define HEARTBEAT_TRIS _TRISA0
#define HEARTBEAT_LAT _LATA0
void heartbeat_init();
void heartbeat_toggle();

void delay_ns(uint32_t count);
void delay_us(uint32_t count);
void delay_ms(uint32_t count);

#define cycles_per_us() ( FCY / 1000000L )
#define cycles_to_us(a) ( (a) / cycles_per_us() )
#define us_to_cycles(a) ( (a) * cycles_per_us() )

#endif
