watsonboyett/CanonCar/(commit log)

2013-07-01 initial commit of exiting project
    [Car.brd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]
2014-11-26 Uhh... Not really sure what's changed...
    [Car.brd, Car.job.brd, Car.sch]
2014-12-01 Completed Rev.A of v2 hardware.
    [Car.brd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]
2014-12-14 Checkpointing. (about to make so potentially dangerous changes.)
    [Car.brd, Car.sch]
2014-12-14 Fixed a number of issues discovered from Rev. A boards.
    [Car.brd, Car.sch]
2014-12-15 Minor cleanup.
    [Car.brd, Car.sch]
2014-12-21 Updating for new V2 hardware (not working yet).
    [analogio.h, digitalio.h, motor.c, motor.h]
2015-04-24 Fixed motor control functions. Cleaned up formatting and type declarations.
    [analogio.c, analogio.h, controller.c, digitalio.c, digitalio.h, main.c, motor.c]
2015-04-25 Fixed PGD/PGC error (swapped) in schematic.
    [Car.brd, Car.sch]
2015-04-28 Fixed external (spi) digital io functions.
    [analogio.c, analogio.h, digitalio.c, digitalio.h, io.c, io.h, main.c, pins.c]
2015-04-29 Fixed analog io functions.
    [analogio.c, analogio.h, digitalio.c, digitalio.h, io.c, io.h, main.c, pins.c]
2015-04-29 Swapped non-analog input pins for ones that do support analog input. Significantly cleaned up schematic.
    [Car.brd, Car.sch]
2015-04-30 Added more pin definitions.
2015-04-30 Added image of v2rB schematic for reference.
2015-05-01 Fixed spurrious spi write issue. Started working on motor library.
    [digitalio.c, main.c, motor.c, spi_util.c]
2015-05-07 More schematic and layout cleanup.
    [Car.brd, Car.sch]
2015-05-08 Adding low pass filters to PWM outputs (for motor VREF).
    [Car.brd, Car.job.brd, Car.sch]
2015-05-09 More updates to schematic and layout. Checkpointing.
    [Car.brd, Car.sch]
2015-05-22 Fixed motor current level enums. Delay functions still broken (maybe more broken now).
    [digitalio.c, main.c, motor.c, motor.h, pins.c, pins.h, util.c, util.h]
2015-05-30 Started routing pcb for reals.
    [Car.brd, Car.sch]
2015-06-08 Routed power traces.
    [Car.brd, Car.sch]
2015-06-09 Finished routing power signals.
    [Car.brd, Car.sch]
2015-06-11 Fixed bug where SPI IO chips were ignoring their HW addresses.
    [digitalio.c, main.c, motor.c, util.c]
2015-06-12 'Fixed' delay functions. They now provide the correct delay intervals, but are very hardware specific.
    [main.c, util.c, util.h]
2015-08-31 Finalized(-ish) routing for V2
    [Car.brd, Car.sch]
2015-11-19 Added v3 files. Still WIP.
    [Car.brd, Car.sch]
2015-11-19 Updates to v2? I don't really know. It's ben a while...
    [Car.brd]
2015-11-20 Started layout for v3.
    [Car.brd, Car.sch]
2015-11-21 Continued working layout. Added USB components. Remapped some pins.
    [Car.brd, Car.sch]
2015-11-21 More routing (~50% complete). Normalized/placed texts.
    [Car.brd, Car.sch]
2015-12-06 Minor board tweaks.
    [Car.brd]
2015-12-06 Reorganized firmware file structure. Fixed SPI read/write methods.
    [analogio.c, analogio.h, common.h, configuration_bits.c, controller.c, device.h]
2015-12-07 Fixed some quirks with analog read functions. Added test app for wired remote control of car.
    [analogio.c, analogio.h, main.c, pins.c]
2015-12-07 Minor tweaks to layout/DRU. Changed via stop mask values.
    [Car.brd, Car.sch]
2015-12-22 Finished routing power for motor driver 1.
    [Car.brd, Car.sch]
2016-01-06 Finished routing power lines and other significant signals.
    [Car.brd, Car.sch]
2016-01-06 Fixed some part values. Cleaned up schematic and board names/values.
    [Car.brd, DRILEGEND.CFG]
